digitaldanny/AudioEffectsGlove/docs/PinoutTable_v2.0.0__C2000__Breadboard_v1.0.0.xlsx

Creation Date | 2020-11-01
Last Modified Date | 2020-11-01
Breadboard Component | Breadboard Component Pin | C2000 Top-Left Left pins | C2000 Top-Left Right pins | Breadboard Component Pin | Breadboard Component | Breadboard Component | Breadboard Component Pin | C2000 Top-Right Left pins | C2000 Top-Right Right pins | Breadboard Component Pin | Breadboard Component
 |  | 1 | 21 |  |  | MCP Mux Sel 0 (CD4051BE) | 14 | 40 | 20
 |  | 2 | 22 |  |  | MCP Mux Sel 1 (CD4051BE) | 15 | 39 | 19
 |  | 3 | 23 |  |  | MCP Mux Sel 2 (CD4051BE) | 16 | 38 | 18
 |  | 4 | 24 |  |  |  |  | 37 | 17
 |  | 5 | 25 |  |  |  |  | 36 | 16
 |  | 6 | 26 |  |  |  |  | 35 | 15
 |  | 7 | 27 |  |  |  |  | 34 | 14
 |  | 8 | 28 | 3 | PIP Analog Mux Out (CD4051BE) |  |  | 33 | 13
 |  | 9 | 29 |  |  |  |  | 32 | 12
 |  | 10 | 30 | 3 | MCP Analog Mux Out (CD4051BE) |  |  | 31 | 11 | RX
Breadboard Component | Breadboard Component Pin | C2000 Bottom-Left Left pins | C2000 Bottom-Left Right pins | Breadboard Component Pin | Breadboard Component | Breadboard Component | Breadboard Component Pin | C2000 Bottom-Right Left pins | C2000 Bottom-Right Right pins | Breadboard Component Pin | Breadboard Component
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
