digitaldanny/AudioEffectsGlove/docs/PinoutTable_v1.0.0__RPi_3bp__Breadboard_v1.0.0.xlsx

Creation Date | 2020-10-31
Last Modified Date | 2020-10-31
RPi Left Side Pins | Breadboard HW Component | Breadboard HW Pin | Notes | RPi Right Side Pins | Breadboard HW Component | Breadboard HW Pin | Notes
1 |  |  |  | 2 | Power Regulator Circuit | Toggle Switch | DC 5V Power Supply
3 | Accel/Gyro/Mag | SDA |  | 4
5 | Accel/Gyro/Mag | SCL |  | 6
7 |  |  |  | 8 | HC-05 (Bluetooth) | RXD
9 | Negative Power Rail | Blue Rail | DC Ground | 10 | HC-05 (Bluetooth) | TXD
11 |  |  |  | 12
13 |  |  |  | 14
15 |  |  |  | 16
17 |  |  |  | 18
19 | External ADC (MC3008 IC) | 14 | SPI MOSI for serial communication to external ADC IC | 20
21 | External ADC (MC3008 IC) | 13 | SPI MISO for serial communication to external ADC IC | 22
23 | External ADC (MC3008 IC) | 12 | SPI CLOCK for serial communication to external ADC IC | 24
25 |  |  |  | 26 | External ADC (MC3008 IC) | 15 | SPI CHIP ENABLE for serial communication to external ADC IC
27 |  |  |  | 28
29 |  |  |  | 30
31 |  |  |  | 32
33 |  |  |  | 34
35 |  |  |  | 36 | MCP Mux (CD4051BE IC) | 14 | Mux select lines (MCP and PIP mux selects are wired together on breadboard)
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
