digitaldanny/AudioEffectsGlove/images/HW_Diagram_v3.PNG

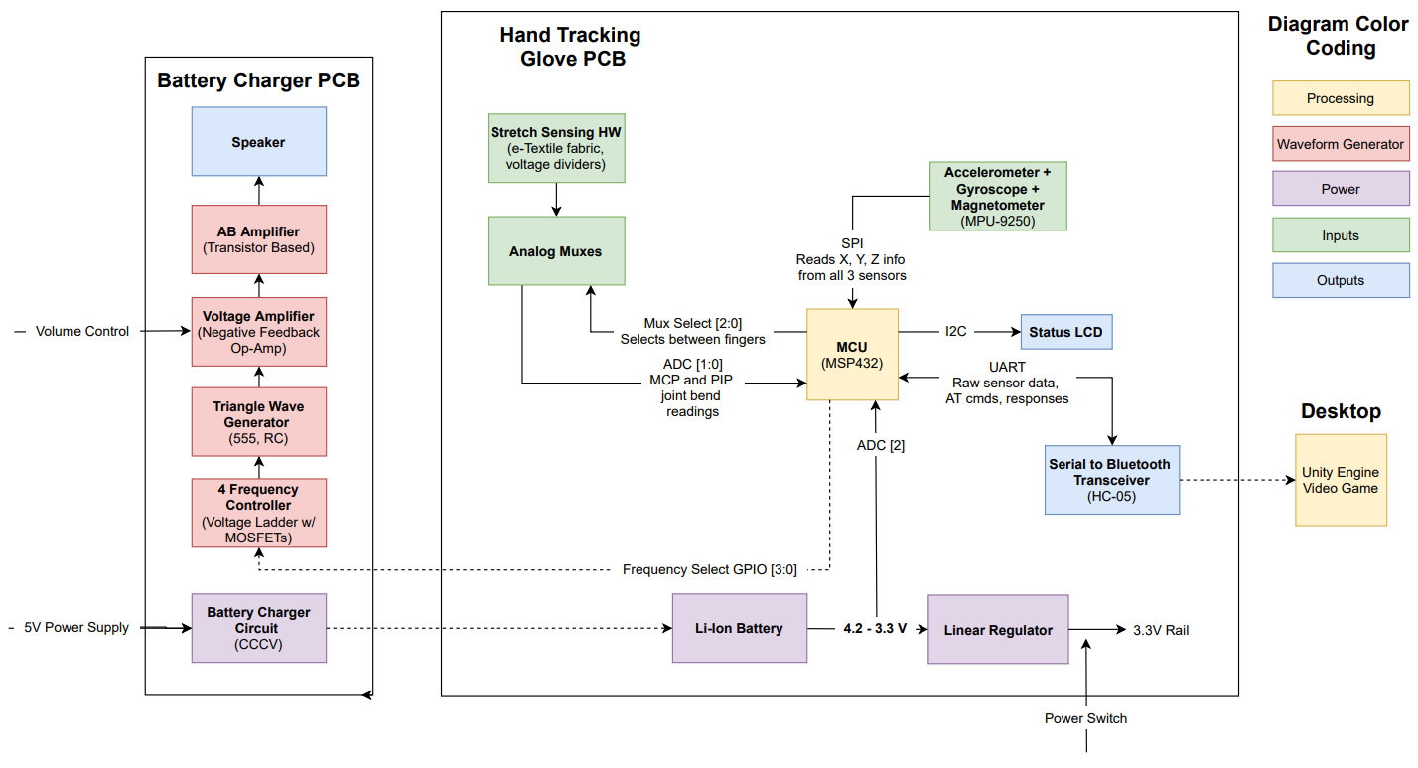
images/HW_Diagram_v3.PNG
