digitaldanny/AudioEffectsGlove/images/prototype_v1.jpg

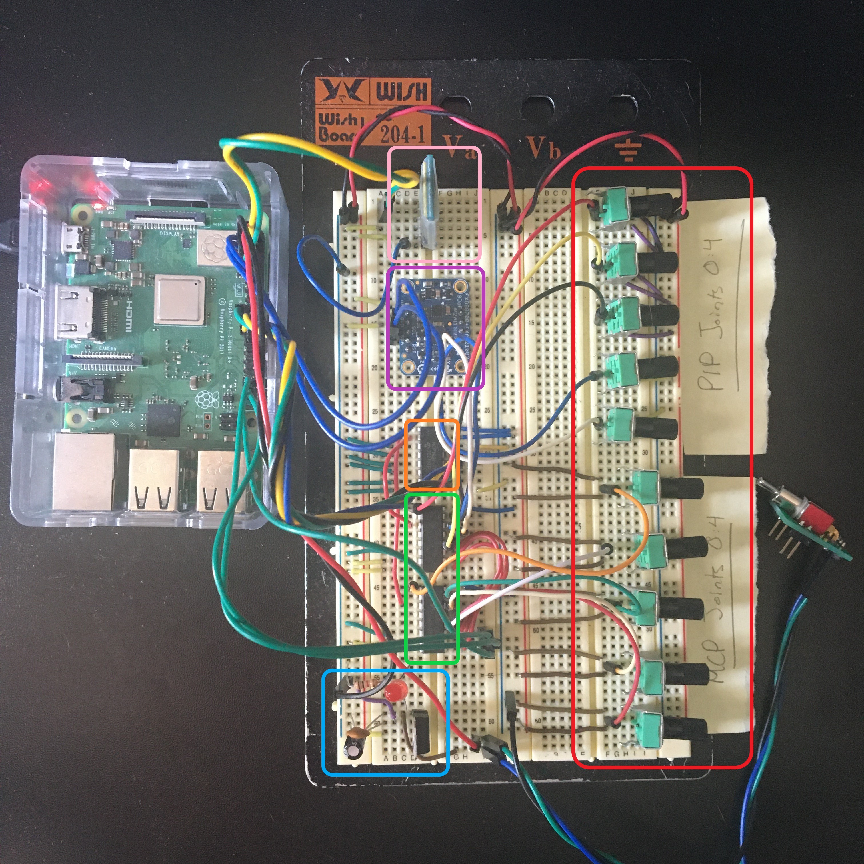
images/prototype_v1.jpg
