digitaldanny/AudioEffectsGlove/images/SW_Flowchart_v2.PNG

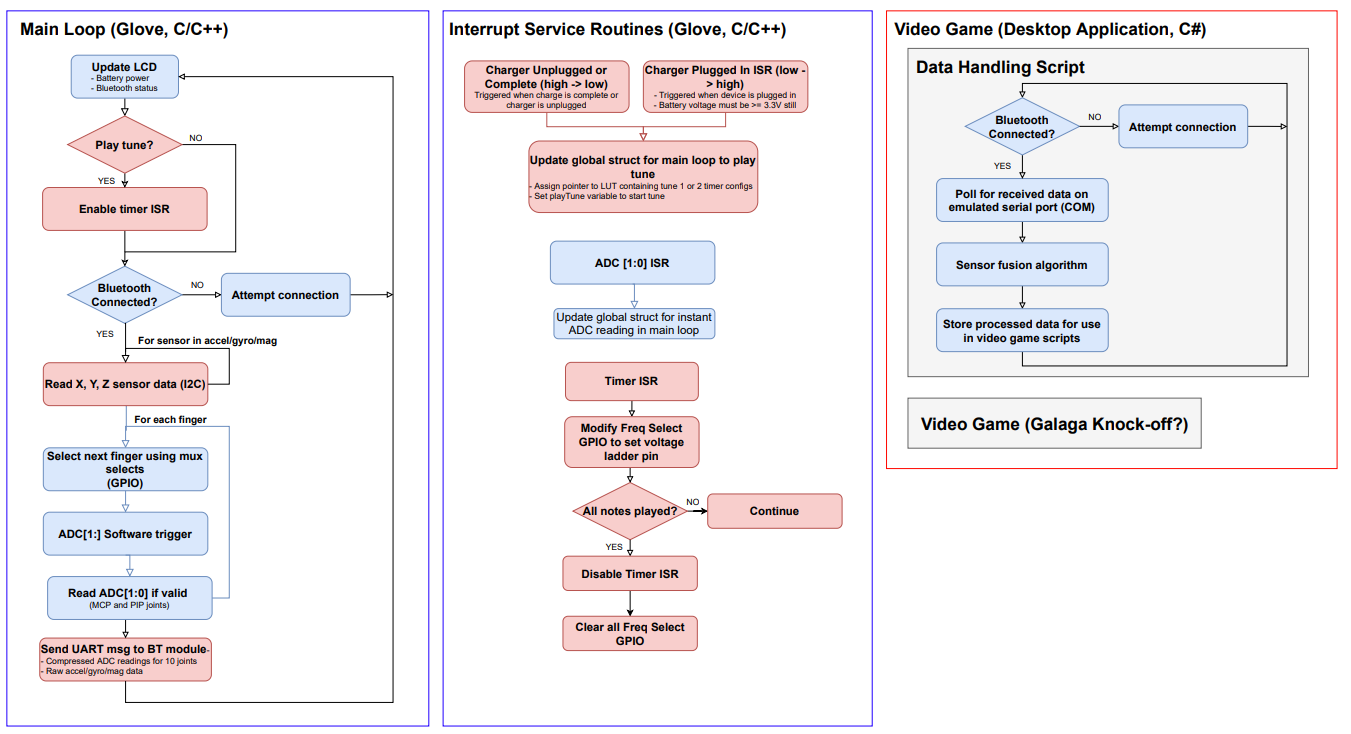
images/SW_Flowchart_v2.PNG
