digitaldanny/AudioEffectsGlove/ltspice/CCCV Battery Charger/CCCV Battery Charger.asc

Battery: voltage; EXP(3.0 4.2 2m 5m 25m 0.005)
D1: diode
D2: diode
DAD+5: voltage; 5
Q1: npn
Q2: npn
Q3: pnp
Q4: pnp
R1: res; 1k
R2: res; 2.2k
R3: res; 4.7k
R4: res; 4k
R5: res; 850
R6: res; 10k
R7: res; 1k
R8: res; .1
R9: res; 100k
R10: res; 100k
R11: res; 1k
R12: res; 1k
R13: res; 4.7k
R14: res; 100
R15: res; 10k
R16: res; 10k
Ra: res; 3.9k
Rb: res; 1k
Roff: res; 220
U1: UniversalOpamp2
U2: UniversalOpamp2
U3: UniversalOpamp2
U4: UniversalOpamp2
U5: LT1117
V1: voltage; 4.15
V2: voltage; 3.9
V3: voltage; 1m
Named nets: 0, DAD_5V, V_schmitt, V_battery, VRef_4_15, VRef_3_9, V_termination
.tran 40m
Constant Current Source (CC)
Constant Voltage Supply (CV)
3.7 - 4.2V Threshold Detector (CC/CV Switching)
2.7V
Direct compare using open loop gain (A) to swing output quicker and invert the signal (using Rail-to-Rail op-amp)
Schmitt = LOW, CC current = ON
Schmitt = HIGH, CV current = ON
3.7 - 4.2 V Triggers
high power shunt resistor (I_battery)
High when I_shunt <= 0.1C (~1.1 mA)
Termination current sensing circuit
Vcv = 4.2V
Icc = 0.1C (1.1mA in this circuit)
Termination = LOW, CV current = ON
Low-side shunt removes common mode rejection ration (CMRR) with low tolerance resistors
