digitaldanny/AudioEffectsGlove/ltspice/Wavegen and AB Amp/Wavegen and AB Amp.asc

A1: dflop
A2: xor
C1: cap; 10n
C2: cap; 10n
C3: cap; 10µ
C4: cap; 10µ
C5: cap; 4.7µ
C6: cap; 10n
C7: cap; 220µ
C8: cap; 100µ
C9: cap
C10: cap; 10n
D1: diode
D2: diode
D3: diode
D4: diode
D5: diode
D6: diode
Q1: npn
Q2: pnp
R1: res
R2: res; 1k
R3: res
R4: res
R5: res; 4.7
R6: res
R7: res; 4.7
R8: res; 1k
R9: res; 1k
R17: res
R_freq1: res; 4.7k
R_freq2: res; 6.8k
R_freq3: res; 8.2k
R_freq4: res; 12k
R_volumePot: res
Ra1: res; 7.5k
Ra3: res; 3.3k
Rb1: res; 100k
Rb2: res; 100k
U1: NE555
U2: NE555
U3: UniversalOpamp2
U4: NE555
V1: voltage
Named nets: outWaveGen555, 0, DAD_5V, outTriangleWave, outBeatClock555, outVolumeAmp, outSpeaker, outChipEnable555, GLOVE_PCB_CONNECT, upDownDir, edgeDetected
Wave generator 555 timer
Square to Triangle Converter
0.5Hz beat timer
These resistances need to be tuned using the formula f=1.44/([Ra + 2*Rb]*c)
8:1 Demux
4029 Up/Down Counter
Volume amplifier
AB Amplifier (Power amp)
2s Edge Sensing Chip Enable
Up / Down Direction Control
Rising and Falling Edge Detector
