digitaldanny/AudioEffectsGlove/ltspice/Flex Sensor to ADC/Flex Sensor to ADC.asc

Q1: pnp
R1: res; 8.2k
R2: res; 1.5k
R3: res; 10k
R_flex: res; R=V(Vresistance)
R_offset: res; 10
Rdiv: res; 18k
Rg1: res; 1.4k
Rg2: res; 1.4k
Rin1: res; 1k
Rin2: res; 1k
U1: UniversalOpamp2
U2: UniversalOpamp2
U3: UniversalOpamp2
V1: voltage; 3.3
V2: voltage; 3.3
Vs: voltage; EXP(12k 250 0 5m 1 1)
Named nets: 0, Vresistance, MuxOut, V_33, Vbias, V_boosted, V_linear, V_33N
Flex sensor voltage divider mux output
.tran 100m
Voltage reference to subtract in differential amp
Differential amp to boost voltage range of interest
Anti-log amplifier to produce linear output from log input
