digitaldanny/AudioEffectsGlove/hw_checkout/CFAL6448A_SPI/CFAL6448A_SPI.ino

//===========================================================================
//
//  Code written for Seeeduino v4.2 runnung at 3.3v
//
//  CRYSTALFONTZ CFAL6448A-066B 64x48 OLED in in 4-wire, 8-bit SPI mode
//
//  ref: https://www.crystalfontz.com/product/cfal6448a066bw
//
//  2017 - 06 - 23 Brent A. Crosby
//===========================================================================
//This is free and unencumbered software released into the public domain.
//
//Anyone is free to copy, modify, publish, use, compile, sell, or
//distribute this software, either in source code form or as a compiled
//binary, for any purpose, commercial or non-commercial, and by any
//means.
//
//In jurisdictions that recognize copyright laws, the author or authors
//of this software dedicate any and all copyright interest in the
//software to the public domain. We make this dedication for the benefit
//of the public at large and to the detriment of our heirs and
//successors. We intend this dedication to be an overt act of
//relinquishment in perpetuity of all present and future rights to this
//software under copyright law.
//
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
//For more information, please refer to <http://unlicense.org/>
//===========================================================================
#include <SPI.h>
#include "bitmaps.h"
//============================================================================
// The CFAL6448A-066B is a 3.3v device. You need a 3.3v Arduino to operate this
// code properly. We used a seeedunio v4.2 set to 3.3v:
//https://www.crystalfontz.com/product/cfapn15062-seeeduino-arduino-clone-microprocessor
//or
// http://www.seeedstudio.com/item_detail.html?p_id=2517
// 
// LCD SPI & control lines
//   ARD      | Port | LCD
// -----------+------+-------------------------
//  #8/D8     |  PB0 | LCD_RS
//  #9/D9     |  PB1 | LCD_RESET
// #10/D10    |  PB2 | LCD_CS_NOT (or SPI SS)
// #11/D11    |  PB3 | LCD_MOSI   (hardware SPI)
// #12/D12    |  PB4 | not used   (would be MISO)
// #13/D13    |  PB5 | LCD_SCK    (hardware SPI)
//
// GND => BS0 (Selects 4-wire, 8-bit SPI)
// GND => BS1 (Selects 4-wire, 8-bit SPI)
// 3.3v => VBAT
// 3.3v => VDD
//
#define CLR_RS    (PORTB &= ~(0x01))
#define SET_RS    (PORTB |=  (0x01))
#define CLR_RESET (PORTB &= ~(0x02))
#define SET_RESET (PORTB |=  (0x02))
#define CLR_CS    (PORTB &= ~(0x04))
#define SET_CS    (PORTB |=  (0x04))
#define CLR_MOSI  (PORTB &= ~(0x08))
#define SET_MOSI  (PORTB |=  (0x08))
#define CLR_SCK   (PORTB &= ~(0x20))
#define SET_SCK   (PORTB |=  (0x20))
//============================================================================
#define NUMBER_OF_SCREENS (13)
#define GEAR_START_SCREEN (5)
const SCREEN_IMAGE *const screens[NUMBER_OF_SCREENS] PROGMEM=
  {
  &Logo_6448,
  &Dimensions_6448,
  &Left_Double_6448,
  &Left_6448,
  &OLED_6448,
  &Gear_0_6448,
  &Gear_1_6448,
  &Gear_2_6448,
  &Gear_3_6448,
  &Gear_4_6448,
  &Gear_5_6448,
  &Gear_6_6448,
  &Gear_7_6448
  };
//============================================================================
void SPI_sendCommand(uint8_t command)
  {
  // Select the LCD's command register
  CLR_RS;
  // Select the LCD controller
  CLR_CS;
  //Send the command via SPI:
  SPI.transfer(command);
  // Deselect the LCD controller
  SET_CS;
  }
//============================================================================
void SPI_sendData(uint8_t data)
  {
  // Select the LCD's data register
  SET_RS;
  // Select the LCD controller
  CLR_CS;
  //Send the data via SPI:
  SPI.transfer(data);
  // Deselect the LCD controller
  SET_CS;
  }
//============================================================================
#define SSD1306B_00_SET_LOWER_COLUMN_ADDRESS_BIT (0x00)
#define SSD1306B_10_SET_UPPER_COLUMN_ADDRESS_BIT (0x10)
#define SSD1306B_B0_SET_PAGE_START_ADDRESS_BIT   (0xB0)
#define SSD1306B_DCDC_CONFIG_PREFIX_8D           (0x8D)
#define SSD1306B_DCDC_CONFIG_7p5v_14             (0x14)
#define SSD1306B_DCDC_CONFIG_6p0v_15             (0x15)
#define SSD1306B_DCDC_CONFIG_8p5v_94             (0x94)
#define SSD1306B_DCDC_CONFIG_9p0v_95             (0x95)
#define SSD1306B_DISPLAY_OFF_YES_SLEEP_AE        (0xAE)
#define SSD1306B_DISPLAY_ON_NO_SLEEP_AF          (0xAF)
#define SSD1306B_CLOCK_DIVIDE_PREFIX_D5          (0xD5)
#define SSD1306B_MULTIPLEX_RATIO_PREFIX_A8       (0xA8)
#define SSD1306B_DISPLAY_OFFSET_PREFIX_D3        (0xD3)
#define SSD1306B_DISPLAY_START_LINE_40           (0x40)
#define SSD1306B_SEG0_IS_COL_0_A0                (0xA0)
#define SSD1306B_SEG0_IS_COL_127_A1              (0xA1)
#define SSD1306B_SCAN_DIR_UP_C0                  (0xC0)
#define SSD1306B_SCAN_DIR_DOWN_C8                (0xC8)
#define SSD1306B_COM_CONFIG_PREFIX_DA            (0xDA)
#define SSD1306B_COM_CONFIG_SEQUENTIAL_LEFT_02   (0x02)
#define SSD1306B_COM_CONFIG_ALTERNATE_LEFT_12    (0x12)
#define SSD1306B_COM_CONFIG_SEQUENTIAL_RIGHT_22  (0x22)
#define SSD1306B_COM_CONFIG_ALTERNATE_RIGHT_32   (0x32)
#define SSD1306B_CONTRAST_PREFIX_81              (0x81)
#define SSD1306B_PRECHARGE_PERIOD_PREFIX_D9      (0xD9)
#define SSD1306B_VCOMH_DESELECT_PREFIX_DB        (0xDB)
#define SSD1306B_VCOMH_DESELECT_0p65xVCC_00      (0x00)
#define SSD1306B_VCOMH_DESELECT_0p71xVCC_10      (0x10)
#define SSD1306B_VCOMH_DESELECT_0p77xVCC_20      (0x20)
#define SSD1306B_VCOMH_DESELECT_0p83xVCC_30      (0x30)
#define SSD1306B_ENTIRE_DISPLAY_FORCE_ON_A5      (0xA5)
#define SSD1306B_ENTIRE_DISPLAY_NORMAL_A4        (0xA4)
#define SSD1306B_INVERSION_NORMAL_A6             (0xA6)
#define SSD1306B_INVERSION_INVERTED_A7           (0xA7)
//============================================================================
void Set_Address(uint8_t column, uint8_t page)
  {
  //Set column-lower nibble
  SPI_sendCommand(SSD1306B_00_SET_LOWER_COLUMN_ADDRESS_BIT|(column&0x0F));
  //Set column-upper nibble
  SPI_sendCommand(SSD1306B_10_SET_UPPER_COLUMN_ADDRESS_BIT|((column>>4)&0x0F));
  //Set page address, limiting from 0 to 7
  SPI_sendCommand(SSD1306B_B0_SET_PAGE_START_ADDRESS_BIT|(page&0x0F));
  }
//============================================================================
void show_64_x_48_bitmap(const SCREEN_IMAGE *OLED_image)
  {
  uint8_t
    column;
  uint8_t
    row;

  for(row=0;row<6;row++)
    {
    //Display is offest by 32 columns
    //(only 64 used of a possible 128, 32 discarded each side)
    Set_Address(32,row);

    // Select the LCD's data register
    SET_RS;
    // Select the LCD controller
    CLR_CS;
    for(column=0;column<64;column++)
      {
      //Read this byte from the program memory / flash,
      //Send the data via SPI:
      SPI.transfer(pgm_read_byte( &(OLED_image  ->bitmap_data[row][column]) ));
      }
    // Deselect the LCD controller
    SET_CS;    
    }
  }
//============================================================================
void Initialize_CFAL6448A(void)
  {
  //Thump the reset.  
  _delay_ms(1);
  CLR_RESET;
  _delay_ms(1);
  SET_RESET;
  _delay_ms(1);

  //Set the display to sleep mode for the rest of the init.
  SPI_sendCommand(SSD1306B_DISPLAY_OFF_YES_SLEEP_AE);

  //Set the clock speed, nominal ~105FPS
  //Low nibble is divide ratio
  //High level is oscillator frequency
  SPI_sendCommand(SSD1306B_CLOCK_DIVIDE_PREFIX_D5);
  SPI_sendCommand(0x80);//177Hz measured

  //Set the multiplex ratio to 1/48
  //Default is 0x3F (1/64 Duty), we need 0x2F (1/48 Duty)
  SPI_sendCommand(SSD1306B_MULTIPLEX_RATIO_PREFIX_A8);
  SPI_sendCommand(0x2F);  

  //Set the display offset to 0 (default)
  SPI_sendCommand(SSD1306B_DISPLAY_OFFSET_PREFIX_D3);
  SPI_sendCommand(0x00);

  //Set the display RAM display start line to 0 (default)
  //Bits 0-5 can be set to 0-63 with a bitwise or
  SPI_sendCommand(SSD1306B_DISPLAY_START_LINE_40);

  //Enable DC/DC converter, 9.0v
  SPI_sendCommand(SSD1306B_DCDC_CONFIG_PREFIX_8D);
  SPI_sendCommand(SSD1306B_DCDC_CONFIG_9p0v_95);

  //Map the columns correctly for our OLED glass layout
  SPI_sendCommand(SSD1306B_SEG0_IS_COL_127_A1);

  //Set COM output scan correctly for our OLED glass layout
  SPI_sendCommand(SSD1306B_SCAN_DIR_DOWN_C8);

  //Set COM pins correctly for our OLED glass layout
  SPI_sendCommand(SSD1306B_COM_CONFIG_PREFIX_DA);
  SPI_sendCommand(SSD1306B_COM_CONFIG_ALTERNATE_LEFT_12);

  //Set Contrast Control / SEG Output Current / Iref
  SPI_sendCommand(SSD1306B_CONTRAST_PREFIX_81);
  SPI_sendCommand(0xFF);  //magic # from factory

  //Set precharge (low nibble) / discharge (high nibble) timing
  //precharge = 15 clocks
  //discharge = 15 clocks
  SPI_sendCommand(SSD1306B_PRECHARGE_PERIOD_PREFIX_D9); //Set Pre-Charge period        
  SPI_sendCommand(0xFF); 

  //Set VCOM Deselect Level
  SPI_sendCommand(SSD1306B_VCOMH_DESELECT_PREFIX_DB);
  SPI_sendCommand(SSD1306B_VCOMH_DESELECT_0p65xVCC_00); 

  //Make sure Entire Display On is disabled (default)
  SPI_sendCommand(SSD1306B_ENTIRE_DISPLAY_NORMAL_A4);

  //Make sure display is not inverted (default)
  SPI_sendCommand(SSD1306B_INVERSION_NORMAL_A6);

  //Get out of sleep mode, into normal operation
  SPI_sendCommand(SSD1306B_DISPLAY_ON_NO_SLEEP_AF);
  }
//============================================================================
uint8_t
  gear_dir;
//----------------------------------------------------------------------------
void setup( void )
  {
  // LCD SPI & control lines
  //   ARD      | Port | LCD
  // -----------+------+-------------------------
  //  #8/D8     |  PB0 | LCD_RS
  //  #9/D9     |  PB1 | LCD_RESET
  // #10/D10    |  PB2 | LCD_CS_NOT (or SPI SS)
  // #11/D11    |  PB3 | LCD_MOSI   (hardware SPI)
  // #12/D12    |  PB4 | not used   (would be MISO)
  // #13/D13    |  PB5 | LCD_SCK    (hardware SPI)
  //Set the control lines to output
  DDRB |= 0x2F;

  //Drive the control lines to a reasonable starting state.
  CLR_RESET;
  CLR_RS;
  SET_CS;
  CLR_MOSI;
  CLR_SCK;

  // Initialize SPI. By default the clock is 4MHz.
  SPI.begin();
  //Bump the clock to 8MHz. Appears to be the maximum.
  SPI.beginTransaction(SPISettings(8000000, MSBFIRST, SPI_MODE0));

  //Fire up the SPI OLED
  Initialize_CFAL6448A();

  gear_dir=0;
  }
//----------------------------------------------------------------------------
void  loop(void)
  {
  uint8_t
    current_screen;
  //Put up some bitmaps from flash
  for(current_screen=0;current_screen<GEAR_START_SCREEN;current_screen++)
    {
    show_64_x_48_bitmap((SCREEN_IMAGE *)pgm_read_word(&screens[current_screen]));
    //Wait a bit . . .
    _delay_ms(1500);
    if(current_screen < 2)
      {
      //Wait a little extra for the logo & dimensions
      _delay_ms(750);
      }
    }
  //Loop the gear animation.
  uint8_t
    repeat;
  if(0==gear_dir)
    {
    for(repeat=0;repeat<25;repeat++)
      {
      for(current_screen=GEAR_START_SCREEN;current_screen<NUMBER_OF_SCREENS;current_screen++)
        {
        show_64_x_48_bitmap((SCREEN_IMAGE *)pgm_read_word(&screens[current_screen]));
        _delay_ms(20);        
        }
      }
    gear_dir=1;  
    }
  else
    {
    for(repeat=0;repeat<25;repeat++)
      {
      for(current_screen=NUMBER_OF_SCREENS-1;GEAR_START_SCREEN<=current_screen;current_screen--)
        {
        show_64_x_48_bitmap((SCREEN_IMAGE *)pgm_read_word(&screens[current_screen]));
        _delay_ms(20);        
        }
      }
    gear_dir=0;  
    }
  }
//============================================================================
