digitaldanny/AudioEffectsGlove/device/src/handTrackingGlove.cpp

#include "build_switches.h"
#if ENABLE_HAND_TRACKING_GLOVE

#include "entry_points.h"
#include "data_packet_protocol.h"
#include "hc05_api.h"
#include "flex_sensors_api.h"
#include "mpu6050_api.h"
#include "sensor_processing_lib.h"
#include "adc_if.h"
#include "state_of_charge_api.h"
#include "lcd_graphics.h"

/*
 * +=====+=====+=====+=====+=====+=====+=====+==5===+=====+=====+=====+=====+
 * DEFINES
 * +=====+=====+=====+=====+=====+=====+=====+=====+=====+=====+=====+=====+
*/

#define ADC_CH_OCV      ADC_CH3 // Open circuit voltage ADC buffer index
#define ADC_CH_CCV      ADC_CH1 // Closed circuit voltage ADC buffer index

#define LCD_ROW_BLUETOOTH_STATUS    0
#define LCD_COL_BLUETOOTH_STATUS    0
#define LCD_ROW_PITCH               1
#define LCD_ROW_ROLL                2
#define LCD_ROW_FLEX1               3
#define LCD_ROW_FLEX2               4
#define LCD_ROW_BATTERY             5

#define BLUETOOTH_TIMEOUT_COUNT     50 // Iteration count between data update to ack is expected to be around 10-15.

/*
 * +=====+=====+=====+=====+=====+=====+=====+=====+=====+=====+=====+=====+
 * STRUCTS
 * +=====+=====+=====+=====+=====+=====+=====+=====+=====+=====+=====+=====+
*/

typedef struct
{
    // Is master Hc-05 is paired with slave Hc-05?
    bool isSlaveConnected;

    // Is the slave Hc-05 ready to receive a new data packet?
    bool isSlaveReadyForUpdate;

    // If slave device has not responded within a certain number of
    // main loop iterations, the C2000 program may have restarted
    // without powering off the slave HC-05.
    uint32_t bluetoothTimeoutCounter;

    // Data packet to transfer
    dataPacket_t packet;

    // Message received back from the slave device
    // This will only contain the opcode portion of the dataPacket_t.
    char* slaveResponse;

    // 14-bit ADC reading for the battery's open circuit voltage.
    uint16_t batteryOcvAdc;
    float stateOfCharge;

    // MPU6050 sensor data
    int16_t accelBuffer[3];
    int16_t gyroBuffer[3];

    // Sensor fusion variables
    unsigned long startTime;
    float delta,wx,wy,wz;
    euler_angles angles;
    vector_ijk fusedVector;
    Quaternion qAcc;
    float pitch;
    float roll;

    // Contains message to write to a single row of the LCD
    char lcdMsg[LCD_MAX_CHARS_PER_LINE];

} gloveState_t;

/*
 * +=====+=====+=====+=====+=====+=====+=====+
 * =====+=====+=====+=====+=====+
 * GLOBALS
 * +=====+=====+=====+=====+=====+=====+=====+=====+=====+=====+=====+=====+
*/

// Contains information about the state of the main program
gloveState_t state;

/*
 * +=====+=====+=====+=====+=====+=====+=====+=====+=====+=====+=====+=====+
 * PROTOTYPES
 * +=====+=====+=====+=====+=====+=====+=====+=====+=====+=====+=====+=====+
*/

bool updateBluetoothConnectionStatus();
bool updateFlexSensorReadings();
void updatePitchRoll();
void updateLcdBatteryCharge();
void SendUpdateToSlave();
void CheckForSlaveAck();

/*
 * +=====+=====+=====+=====+=====+=====+=====+=====+=====+=====+=====+=====+
 * Description: handTrackingGlove
 * This is the main program loop of the hand tracking glove. The below bullet
 * points show the goals of this process.
 *
 * Init
 * - Capture Open Circuit Voltage of the battery to estimate an initial
 *   State of Charge.
 *
 * Loop
 * - Capture ADC readings for each flex sensor on the glove (currently 3 sensors).
 * - Capture accelerometer and gyroscope readings. Use a sensor fusion algorithm
 *   to convert these raw values into euler angles for determining hand orientation.
 * - Capture current draw and update the battery's State of Charge estimation.
 * - Check that the master HC-05 module is still connected to the slave HC-05 module.
 * - Send updated sensor data to the slave HC-05 module (DSP Effects Rack).
 * - Update the LCD with Bluetooth connection status, current draw, and battery charge.
 * +=====+=====+=====+=====+=====+=====+=====+=====+=====+=====+=====+=====+
*/
int handTrackingGlove()
{
    // Initialize glove state variable
    memset((void*)&state, 0, sizeof(gloveState_t));

    // Initialize GPIO to control external hardware power and set power to off
    initExternalHwPower();

    // Start power cycle.
    setExternalHwPower(false);

    // Configure UART to communicate with HC-05 module
    Hc05Api::SetMode(HC05MODE_DATA);

    // Enter Low-power mode and read battery's (near) open circuit voltage
    // and estimate starting battery charge.
    Adc::Init();
    state.batteryOcvAdc = Adc::ReadAdcChannel(ADC_CH_OCV);
    state.stateOfCharge = SocApi::getChargeFromOcv(state.batteryOcvAdc);

    // Finish power cycle.
    setExternalHwPower(true);

    // Configures ADC module and sets mux GPIO
    FlexSensors::Init();

    // Configures SPI module, LCD registers, and clears screen
    LcdGfx::init();

    // Configure I2C and MPU6050 module to read accelerometer and gyroscope sensor data.
    Mpu6050Api::init();

    // Initialize sensor fusion library
    state.fusedVector = vector_3d_initialize(0.0,0.0,-1.0);
    state.qAcc = quaternion_initialize(1.0,0.0,0.0,0.0);
    state.startTime = millis();

    // Slave will be ready for update as soon as master and slave connect
    state.isSlaveReadyForUpdate = true;

    // Main program loop
    while(1)
    {
        // Is slave HC-05 still paired with master HC-05?
        updateBluetoothConnectionStatus();

        // Capture and compress ADC readings for all flex sensors
        updateFlexSensorReadings();

        // Capture the latest accelerometer and gyroscope sensor readings
        Mpu6050Api::readSensorData(state.accelBuffer, state.gyroBuffer);

        // Update pitch and roll angles from accel / gyro readings.
        updatePitchRoll();

        state.stateOfCharge = SocApi::calculateStateOfCharge(state.stateOfCharge, CURRENT_LOAD_STATIC_MA);

        if (state.isSlaveConnected)
        {
            // Send the next packet to the slave device if ready
            if (state.isSlaveReadyForUpdate)
            {
                SendUpdateToSlave();
            }
            else if (state.bluetoothTimeoutCounter >= BLUETOOTH_TIMEOUT_COUNT)
            {
                // Slave device may have disconnected. Reset slaveReady bool
                // for when the device reconnects.
                state.isSlaveReadyForUpdate = true;
            }
            else
            {
                // Wait for ACK response from slave device if packet was
                // sent during current connection.
                CheckForSlaveAck();
            }
        }

        state.bluetoothTimeoutCounter++;

        // Update LCD's battery charge percentage + battery symbol
        updateLcdBatteryCharge();

        delayMs(5);
    }

    return 0;
}

/*
 * +=====+=====+=====+=====+=====+=====+=====+=====+=====+=====+=====+=====+
 * Description: updateLcdBatteryCharge
 * Update LCD's battery charge percentage + battery symbol
 * +=====+=====+=====+=====+=====+=====+=====+=====+=====+=====+=====+=====+
*/
void updateLcdBatteryCharge()
{
    // Update battery charge percentage + icon
    memset(state.lcdMsg, ' ', 10);
    if (state.stateOfCharge > 75.0f)
        sprintf(state.lcdMsg, "[####] %3.0f", state.stateOfCharge);
    else if (state.stateOfCharge > 50.0f)
        sprintf(state.lcdMsg, "[### ] %3.0f", state.stateOfCharge);
    else if (state.stateOfCharge > 25.0f)
        sprintf(state.lcdMsg, "[##  ] %3.0f", state.stateOfCharge);
    else
        sprintf(state.lcdMsg, "[#   ] %3.0f", state.stateOfCharge);

    LcdGfx::drawString(0, LCD_ROW_BATTERY, state.lcdMsg, 10);
}

/*
 * +=====+=====+=====+=====+=====+=====+=====+=====+=====+=====+=====+=====+
 * Description: updateEulerAngles
 * Use the sensor fusion algorithm to convert most recent gyroscope and
 * accelerometer readings into new Pitch and Roll values.
 * +=====+=====+=====+=====+=====+=====+=====+=====+=====+=====+=====+=====+
*/
void updatePitchRoll()
{
    // Update Euler angles from accel / gyro readings
    state.wx = 0.0005323 * state.gyroBuffer[0];
    state.wy = 0.0005323 * state.gyroBuffer[1];
    state.wz = 0.0005323 * state.gyroBuffer[2];

    state.delta = 0.001 * (millis() - state.startTime);

    state.fusedVector = update_fused_vector(state.fusedVector, state.accelBuffer[0],
                                            state.accelBuffer[1], state.accelBuffer[2],
                                            state.wx, state.wy, state.wz,
                                            state.delta);

    state.qAcc = quaternion_from_accelerometer(state.fusedVector.a,
                                               state.fusedVector.b,
                                               state.fusedVector.c);

    state.angles = quaternion_to_euler_angles(state.qAcc);
    state.startTime = millis();

    // Modify the roll values so that the resting sensor has an angle of 0.
    // Rotating right increases towards 180, rotating left decreases towards -180.
    state.roll = state.angles.roll + 180.0f;
    if (state.roll > 180.0f)
    {
        state.roll -= 360.0f;
    }

    // TODO - Modify the pitch values so that there is not any bending at the
    // top of 90 degrees and -90 degrees.
    state.pitch= state.angles.pitch;

    // Typecast to integer and store pitch/roll angles into data packet
    state.packet.pitch = (short)state.pitch;
    state.packet.roll = (short)state.roll;

    // Update LCD with Pitch and Roll angles.
    memset(state.lcdMsg, ' ', LCD_MAX_CHARS_PER_LINE);
    sprintf(state.lcdMsg, "P: %d", state.packet.pitch);
    LcdGfx::drawString(0, LCD_ROW_PITCH, state.lcdMsg, LCD_MAX_CHARS_PER_LINE);

    memset(state.lcdMsg, ' ', LCD_MAX_CHARS_PER_LINE);
    sprintf(state.lcdMsg, "R: %d", state.packet.roll);
    LcdGfx::drawString(0, LCD_ROW_ROLL, state.lcdMsg, LCD_MAX_CHARS_PER_LINE);
}

/*
 * +=====+=====+=====+=====+=====+=====+=====+=====+=====+=====+=====+=====+
 * Description: updateBluetoothConnectionStatus
 * Use the HC-05 STATE pin to check if the master HC-05 is paired with
 * the slave HC-05 on the DSP Effects Rack board.
 *
 * RETURN: Always true
 *
 * +=====+=====+=====+=====+=====+=====+=====+=====+=====+=====+=====+=====+
*/
bool updateBluetoothConnectionStatus()
{
    static uint8_t searchingCount = 0;
    static uint32_t delayCount = 0;
    static char searchingDots[4] = {" "};

    // Check if the master HC-05 module has paired with the
    // slave HC-05 module on the DSP Effects Rack C2000 board.
    state.isSlaveConnected = Hc05Api::IsSlaveConnected();

    if (state.isSlaveConnected)
    {
        memcpy(state.lcdMsg, "BT: Paired", LCD_MAX_CHARS_PER_LINE);
    }
    else
    {
        // Update the searching for slave HC-05 animation
        // (animation shifts a dot to the right in a circular loop)
        searchingDots[searchingCount] = '*';
        searchingDots[(searchingCount-1) & 0x03] = ' ';
        sprintf(state.lcdMsg, "BT: %.4s  ", searchingDots);
        if (delayCount % 10 == 0)
            searchingCount = (searchingCount+1) & 0x03;
        delayCount++;
    }

    LcdGfx::drawString(LCD_COL_BLUETOOTH_STATUS, LCD_ROW_BLUETOOTH_STATUS,
                       state.lcdMsg, LCD_MAX_CHARS_PER_LINE);

    return true;
}

/*
 * +=====+=====+=====+=====+=====+=====+=====+=====+=====+=====+=====+=====+
 * Description: updateFlexSensorReadings
 * Read all compressed flex sensors voltage values (currently 3).
 *
 * RETURN: Always true
 *
 * +=====+=====+=====+=====+=====+=====+=====+=====+=====+=====+=====+=====+
*/
bool updateFlexSensorReadings()
{
    for (uint8_t f = 0; f < FLEX_MAX_NUM_FINGERS; f++)
    {
        state.packet.flexSensors[f] = (unsigned char)FlexSensors::GetJointsData(f);
    }

    // Update LCD with flex sensor readings - flex sensor 0
    memset(state.lcdMsg, 0, LCD_MAX_CHARS_PER_LINE);
    sprintf(state.lcdMsg, "F: %03u", state.packet.flexSensors[0]);
    LcdGfx::drawString(0, LCD_ROW_FLEX1, state.lcdMsg, LCD_MAX_CHARS_PER_LINE);

    // Update LCD with flex sensor readings - flex sensors 1-2
    memset(state.lcdMsg, 0, LCD_MAX_CHARS_PER_LINE);
    sprintf(state.lcdMsg, "F: %03u %03u", state.packet.flexSensors[1], state.packet.flexSensors[2]);
    LcdGfx::drawString(0, LCD_ROW_FLEX2, state.lcdMsg, LCD_MAX_CHARS_PER_LINE);
    return true;
}

/*
 * +=====+=====+=====+=====+=====+=====+=====+=====+=====+=====+=====+=====+
 * Description: SendUpdateToSlave
 * Send latest packet of sensor data to the slave device.
 * +=====+=====+=====+=====+=====+=====+=====+=====+=====+=====+=====+=====+
*/
void SendUpdateToSlave()
{
    state.packet.opCode = DPP_OPCODE_PACKET;
    // Send next packet of data
    if (!Hc05Api::Send((char*) (&state.packet), sizeof(dataPacket_t)))
    {
        while (1); // Send transfer should not fail - trap CPU for debugging.

    }
    // Slave may still be processing the previous update.
    state.isSlaveReadyForUpdate = false;
    state.bluetoothTimeoutCounter = 0;
}

/*
 * +=====+=====+=====+=====+=====+=====+=====+=====+=====+=====+=====+=====+
 * Description: WaitForSlaveAck
 * Loop infinitely while waiting for slave device to notify master that
 * previous data packet was processed.
 * +=====+=====+=====+=====+=====+=====+=====+=====+=====+=====+=====+=====+
*/
void CheckForSlaveAck()
{
    // Wait for ACK response from slave device
    if (Hc05Api::Recv((char**) (&state.slaveResponse), 1))
    {
        // Decode response from slave device
        if (*state.slaveResponse != DPP_OPCODE_ACK)
        {
            while (1); // Slave response should only be an ACK - trap CPU for debugging.
        }

        // Slave has processed the previous update and is ready for a new one.
        state.isSlaveReadyForUpdate = true;
    }
}

#endif // ENABLE_HAND_TRACKING_GLOVE
