digitaldanny/AudioEffectsGlove/hw_checkout/CFAL6448A_SPI/bitmaps.h

#ifndef __bitmaps_h__
#define __bitmaps_h__
typedef struct
  {
  unsigned char
    bitmap_data[6][64];
  } SCREEN_IMAGE;

const SCREEN_IMAGE Logo_6448 PROGMEM =
  {
    {
      {0x00,0x00,0x00,0xC0,0xE0,0xF0,0xF8,0xFC,0x0E,0x07,0x03,0x03,0x07,0xCE,0xEC,0xF0,0xF8,0xFC,0xFE,0x07,0x03,0x03,0x07,0x0E,0xFC,0xF8,0xF0,0xE0,0xC0,0x00,0x00,0x00,0x00,0xF8,0xFE,0x17,0xF1,0xE0,0x00,0x78,0x7F,0x47,0xF8,0xF8,0x40,0x00,0x98,0xF8,0x60,0xF8,0x98,0x00,0x78,0x7F,0x47,0xF8,0xF8,0x40,0x00,0xEE,0xFF,0x11,0xFF,0xEE},
      {0xFE,0xFE,0xFE,0xFE,0xFE,0xFE,0xFE,0xFE,0xFE,0xFE,0xFE,0xFE,0x00,0xFF,0xFF,0xFF,0xFF,0xFF,0xFF,0x00,0xB6,0xB6,0xB6,0xB6,0xB6,0xB6,0xB6,0xB6,0xB6,0xB6,0xB6,0xB6,0xB6,0x00,0x01,0x01,0x01,0x00,0x1C,0x8C,0xC4,0x74,0x3D,0x0D,0x0C,0x00,0x01,0x05,0xFC,0xFD,0x05,0x00,0x00,0x00,0x04,0xFD,0xFD,0x44,0x44,0xEC,0x1D,0x01,0x01,0x00},
      {0x7F,0x7F,0x7F,0x7F,0x7F,0x7F,0x7F,0x7F,0x7F,0x7F,0x7F,0x7F,0x00,0xFF,0xFF,0xFF,0xFF,0xFF,0xFF,0x00,0x6D,0x6D,0x6D,0x6D,0x6D,0x6D,0x6D,0x6D,0x6D,0x6D,0x6D,0x6D,0x6D,0x00,0xC0,0xE0,0x30,0x10,0x16,0x37,0xE5,0xC4,0x04,0xF6,0xF7,0x00,0x00,0x04,0x07,0x07,0xF4,0xF0,0x10,0x10,0x14,0x17,0x07,0xF4,0xF0,0x10,0x10,0x70,0xE0,0x80},
      {0x00,0x00,0x00,0x03,0x07,0x0F,0x1F,0x3F,0x70,0xE0,0xC0,0xC0,0xE0,0x73,0x37,0x0F,0x1F,0x3F,0x7F,0xE0,0xC0,0xC0,0xE0,0x70,0x3F,0x1F,0x0F,0x07,0x03,0x00,0x00,0x00,0x00,0x00,0xFF,0xFF,0x00,0x00,0x00,0x00,0xFF,0xFF,0x00,0xFF,0xFF,0x00,0x00,0x00,0x00,0x00,0xFF,0xFF,0x04,0x04,0x04,0x00,0x00,0xFF,0xFF,0x00,0x00,0x80,0xFF,0x7F},
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
    }
  };


#endif // __bitmaps_h__
