digitaldanny/AudioEffectsGlove/device/src/lcd_graphics.cpp

/*
 * +=====+=====+=====+=====+=====+=====+=====+=====+=====+=====+=====+=====+=====+=====+=====+=====+
 * INCLUDES
 * +=====+=====+=====+=====+=====+=====+=====+=====+=====+=====+=====+=====+=====+=====+=====+=====+
 */

#include "lcd_graphics.h"

// 5x7 font (in 6x8 cell)
unsigned char ucSmallFont[] = {
    0x00,0x00,0x00,0x00,0x00,0x00,0x00,0x3e,0x45,0x51,0x45,0x3e,0x00,0x3e,0x6b,0x6f,
    0x6b,0x3e,0x00,0x1c,0x3e,0x7c,0x3e,0x1c,0x00,0x18,0x3c,0x7e,0x3c,0x18,0x00,0x30,
    0x36,0x7f,0x36,0x30,0x00,0x18,0x5c,0x7e,0x5c,0x18,0x00,0x00,0x18,0x18,0x00,0x00,
    0x00,0xff,0xe7,0xe7,0xff,0xff,0x00,0x3c,0x24,0x24,0x3c,0x00,0x00,0xc3,0xdb,0xdb,
    0xc3,0xff,0x00,0x30,0x48,0x4a,0x36,0x0e,0x00,0x06,0x29,0x79,0x29,0x06,0x00,0x60,
    0x70,0x3f,0x02,0x04,0x00,0x60,0x7e,0x0a,0x35,0x3f,0x00,0x2a,0x1c,0x36,0x1c,0x2a,
    0x00,0x00,0x7f,0x3e,0x1c,0x08,0x00,0x08,0x1c,0x3e,0x7f,0x00,0x00,0x14,0x36,0x7f,
    0x36,0x14,0x00,0x00,0x5f,0x00,0x5f,0x00,0x00,0x06,0x09,0x7f,0x01,0x7f,0x00,0x22,
    0x4d,0x55,0x59,0x22,0x00,0x60,0x60,0x60,0x60,0x00,0x00,0x14,0xb6,0xff,0xb6,0x14,
    0x00,0x04,0x06,0x7f,0x06,0x04,0x00,0x10,0x30,0x7f,0x30,0x10,0x00,0x08,0x08,0x3e,
    0x1c,0x08,0x00,0x08,0x1c,0x3e,0x08,0x08,0x00,0x78,0x40,0x40,0x40,0x40,0x00,0x08,
    0x3e,0x08,0x3e,0x08,0x00,0x30,0x3c,0x3f,0x3c,0x30,0x00,0x03,0x0f,0x3f,0x0f,0x03,
    0x00,0x00,0x00,0x00,0x00,0x00,0x00,0x00,0x06,0x5f,0x06,0x00,0x00,0x07,0x03,0x00,
    0x07,0x03,0x00,0x24,0x7e,0x24,0x7e,0x24,0x00,0x24,0x2b,0x6a,0x12,0x00,0x00,0x63,
    0x13,0x08,0x64,0x63,0x00,0x36,0x49,0x56,0x20,0x50,0x00,0x00,0x07,0x03,0x00,0x00,
    0x00,0x00,0x3e,0x41,0x00,0x00,0x00,0x00,0x41,0x3e,0x00,0x00,0x00,0x08,0x3e,0x1c,
    0x3e,0x08,0x00,0x08,0x08,0x3e,0x08,0x08,0x00,0x00,0xe0,0x60,0x00,0x00,0x00,0x08,
    0x08,0x08,0x08,0x08,0x00,0x00,0x60,0x60,0x00,0x00,0x00,0x20,0x10,0x08,0x04,0x02,
    0x00,0x3e,0x51,0x49,0x45,0x3e,0x00,0x00,0x42,0x7f,0x40,0x00,0x00,0x62,0x51,0x49,
    0x49,0x46,0x00,0x22,0x49,0x49,0x49,0x36,0x00,0x18,0x14,0x12,0x7f,0x10,0x00,0x2f,
    0x49,0x49,0x49,0x31,0x00,0x3c,0x4a,0x49,0x49,0x30,0x00,0x01,0x71,0x09,0x05,0x03,
    0x00,0x36,0x49,0x49,0x49,0x36,0x00,0x06,0x49,0x49,0x29,0x1e,0x00,0x00,0x6c,0x6c,
    0x00,0x00,0x00,0x00,0xec,0x6c,0x00,0x00,0x00,0x08,0x14,0x22,0x41,0x00,0x00,0x24,
    0x24,0x24,0x24,0x24,0x00,0x00,0x41,0x22,0x14,0x08,0x00,0x02,0x01,0x59,0x09,0x06,
    0x00,0x3e,0x41,0x5d,0x55,0x1e,0x00,0x7e,0x11,0x11,0x11,0x7e,0x00,0x7f,0x49,0x49,
    0x49,0x36,0x00,0x3e,0x41,0x41,0x41,0x22,0x00,0x7f,0x41,0x41,0x41,0x3e,0x00,0x7f,
    0x49,0x49,0x49,0x41,0x00,0x7f,0x09,0x09,0x09,0x01,0x00,0x3e,0x41,0x49,0x49,0x7a,
    0x00,0x7f,0x08,0x08,0x08,0x7f,0x00,0x00,0x41,0x7f,0x41,0x00,0x00,0x30,0x40,0x40,
    0x40,0x3f,0x00,0x7f,0x08,0x14,0x22,0x41,0x00,0x7f,0x40,0x40,0x40,0x40,0x00,0x7f,
    0x02,0x04,0x02,0x7f,0x00,0x7f,0x02,0x04,0x08,0x7f,0x00,0x3e,0x41,0x41,0x41,0x3e,
    0x00,0x7f,0x09,0x09,0x09,0x06,0x00,0x3e,0x41,0x51,0x21,0x5e,0x00,0x7f,0x09,0x09,
    0x19,0x66,0x00,0x26,0x49,0x49,0x49,0x32,0x00,0x01,0x01,0x7f,0x01,0x01,0x00,0x3f,
    0x40,0x40,0x40,0x3f,0x00,0x1f,0x20,0x40,0x20,0x1f,0x00,0x3f,0x40,0x3c,0x40,0x3f,
    0x00,0x63,0x14,0x08,0x14,0x63,0x00,0x07,0x08,0x70,0x08,0x07,0x00,0x71,0x49,0x45,
    0x43,0x00,0x00,0x00,0x7f,0x41,0x41,0x00,0x00,0x02,0x04,0x08,0x10,0x20,0x00,0x00,
    0x41,0x41,0x7f,0x00,0x00,0x04,0x02,0x01,0x02,0x04,0x00,0x80,0x80,0x80,0x80,0x80,
    0x00,0x00,0x03,0x07,0x00,0x00,0x00,0x20,0x54,0x54,0x54,0x78,0x00,0x7f,0x44,0x44,
    0x44,0x38,0x00,0x38,0x44,0x44,0x44,0x28,0x00,0x38,0x44,0x44,0x44,0x7f,0x00,0x38,
    0x54,0x54,0x54,0x08,0x00,0x08,0x7e,0x09,0x09,0x00,0x00,0x18,0xa4,0xa4,0xa4,0x7c,
    0x00,0x7f,0x04,0x04,0x78,0x00,0x00,0x00,0x00,0x7d,0x40,0x00,0x00,0x40,0x80,0x84,
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
};

/*
 * +=====+=====+=====+=====+=====+=====+=====+=====+=====+=====+=====+=====+=====+=====+=====+=====+
 * FUNCTION IMPLEMENTATIONS
 * +=====+=====+=====+=====+=====+=====+=====+=====+=====+=====+=====+=====+=====+=====+=====+=====+
 */

bool LcdGfx::init()
{
    lcd_setup(); // lcd register configuration
    LcdGfx::drawFill(0x00); // clear screen
    return true;
}

/*
 * +-----+-----+-----+-----+-----+-----+-----+-----+-----+-----+-----+-----+-----+
 * DESCRIPTION: LcdGfx::writeDataBlock
 * Initialize GPIO to control the mux selects.
 *
 * NOTE - This function belongs in the cfa6448A_lcd.cpp file, but I am placing it
 * here to minimize changing the 3rd party libraries as much as possible.
 *
 * INPUTS:
 * @data - Pointer to buffer to transfer.
 * @len - Length of the data buffer.
 *
 * RETURN: True if transfer was successful.
 * +-----+-----+-----+-----+-----+-----+-----+-----+-----+-----+-----+-----+-----+
*/
bool LcdGfx::writeDataBlock(unsigned char* data, uint16_t len)
{
    // Select the LCD's data register
    SET_RS;

    // Select the LCD controller
    CLR_CS;

    for(uint16_t i = 0; i < len; i++)
    {
      //Read this byte from the program memory / flash,
      //Send the data via SPI:
      SPI.transfer(data[i]);
    }

    // Deselect the LCD controller
    SET_CS;
    return true;
}

/*
 * +-----+-----+-----+-----+-----+-----+-----+-----+-----+-----+-----+-----+-----+
 * DESCRIPTION: LcdGfx::drawString
 * Draws input message to a specified position on the screen.
 *
 * INPUTS:
 * @x - Starting column in character widths (6 for small font).
 * @y - Starting row in memory pages (8 lines each).
 * @msg - Pointer to message to write.
 * @msgLen - Number of characters in the message.
 *
 * RETURN: True if transfer was successful.
 * +-----+-----+-----+-----+-----+-----+-----+-----+-----+-----+-----+-----+-----+
*/
#define CHAR_WIDTH  6
bool LcdGfx::drawString(uint8_t x, uint8_t y, char* msg, uint16_t msgLen)
{
    unsigned char *s;

    Set_Address(CHAR_WIDTH*(x + 6), y);
    for (uint16_t i = 0; i < msgLen; i++)
    {
        s = &ucSmallFont[(unsigned char)msg[i]*CHAR_WIDTH];
        writeDataBlock(s, CHAR_WIDTH);
    }
    return true;
}

/*
 * +-----+-----+-----+-----+-----+-----+-----+-----+-----+-----+-----+-----+-----+
 * DESCRIPTION: LcdGfx::drawFill
 * Fills entire LCD with a byte pattern (0x00 for all off, 0xFF for all on).
 *
 * INPUTS:
 * @pattern - Pattery to fill LCD with.
 *
 * RETURN: True if transfer was successful.
 * +-----+-----+-----+-----+-----+-----+-----+-----+-----+-----+-----+-----+-----+
*/
#define NUM_LINES   8
#define NUM_COLS    8
unsigned char patternBuf[16*NUM_COLS];
bool LcdGfx::drawFill(unsigned char pattern)
{
    memset(patternBuf, pattern, 16*NUM_COLS);

    for (uint8_t y = 0; y < NUM_LINES; y++)
    {
        Set_Address(0, y); // set to (0,Y)
        writeDataBlock(patternBuf, 16*NUM_COLS); // fill with data byte
    } // for y
    return 0;
}
