digitaldanny/AudioEffectsGlove/device/inc/target_hw_common.h

/*
 * +=====+=====+=====+=====+=====+=====+=====+=====+=====+=====+=====+=====+
 * DESCRIPTION: setup_target_hw.h
 * This file contains headers/functions to initialize **non-module** target hardware
 * and common helper functions for hardware setup.
 *
 * Examples of inits in this file) Setting clock speed, disabling WDT
 * Examples of inits NOT in this file) Configuring UART for transmitting Bluetooth data
 * +=====+=====+=====+=====+=====+=====+=====+=====+=====+=====+=====+=====+
*/

/*
 * +=====+=====+=====+=====+=====+=====+=====+=====+=====+=====+=====+=====+
 * INCLUDES
 * +=====+=====+=====+=====+=====+=====+=====+=====+=====+=====+=====+=====+
*/
#ifndef _SETUP_TARGET_HARDWARE
#define _SETUP_TARGET_HARDWARE

#include <string.h>
#include "build_switches.h"

#if TARGET_HW_C2000
extern "C" {
 #include "device.h"
}
#endif // TARGET_HW_C2000

#if TARGET_HW_MSP432
extern "C" {
 #include "driverlib.h"
}
#endif // TARGET_HW_MSP432

/*
 * +=====+=====+=====+=====+=====+=====+=====+=====+=====+=====+=====+=====+
 * DEFINES
 * +=====+=====+=====+=====+=====+=====+=====+=====+=====+=====+=====+=====+
*/

/// SYSTEM INFO DEFINES ///
#define SYSINFO_EXTERNALHWPOWER_ENABLE  systemInfo.externalHwPowerEnable

/// SYSTEM IO DEFINES ///
#define SYSIO_PIN_EXTERNALHWPOWER_PORT  systemIO.externalHwPower.port
#define SYSIO_PIN_EXTERNALHWPOWER_PIN   systemIO.externalHwPower.pin

#define SYSIO_PIN_BLUETOOTHENABLE_PORT  systemIO.bluetoothEn.port
#define SYSIO_PIN_BLUETOOTHENABLE_PIN   systemIO.bluetoothEn.pin

/*
 * +=====+=====+=====+=====+=====+=====+=====+=====+=====+=====+=====+=====+
 * STRUCTS
 * +=====+=====+=====+=====+=====+=====+=====+=====+=====+=====+=====+=====+
*/

/*
 * +-----+-----+-----+-----+-----+-----+-----+-----+-----+
 * SUMMARY: pinPort_t
 * This struct contains port/pin parameters for an MSP432 pin.
 * +-----+-----+-----+-----+-----+-----+-----+-----+-----+
 */
typedef struct
{
#ifdef TARGET_HW_MSP432
    uint_fast8_t port;
    uint_fast16_t pin;
#endif // TARGET_HW_MSP432
} pinPort_t;

/*
 * +-----+-----+-----+-----+-----+-----+-----+-----+-----+
 * SUMMARY: systemInfo_t
 * This struct contains information about the system hardware's
 * state.
 *
 * FIELD DESCRIPTIONS:
 * @externalHwPowerEnable - Issue #45
 *  Is power enabled for other hardware (HC-05, MPU6500, Flex Sensors, etc)?
 *@millisCount - Issue #64
 *  Number of milliseconds counted since the program started running.
 * +-----+-----+-----+-----+-----+-----+-----+-----+-----+
 */
typedef struct
{
    bool externalHwPowerEnable;
    uint32_t millisCount;
} systemInfo_t;


/*
 * +-----+-----+-----+-----+-----+-----+-----+-----+-----+
 * SUMMARY: systemIO_t
 * This struct contains information about the system hardware's
 * state.
 *
 * FIELD DESCRIPTIONS:
 * @externalHwPower - Issue #45
 *  Enables power for external hardware (LCD, MPU6500, HC-05, etc)
 * @bluetoothEn - Issue #37
 *  Controls whether HC-05 module operates in data or command mode.
 * @bluetoothState - Issue #37
 *  Checks if HC-05 master is connected to slave device.
 * @uartTx/Rx
 *  Uart pins to communicate with HC-05 device.
 * @i2cSda/Scl
 *  I2C lines to communicate with MPU6050.
 * @spiMiso/Mosi/Clk/Cs1
 *  SPI lines to communicate with LCD. Cs1 is a generic GPIO.
 * @lcdRs
 *  Register select determines if LCD is in data or command mode.
 * @lcdReset
 *  Active low reset for LCD.
 * @flexAdc
 *  ADC14 pin for reading amplified and filtered flex sensor outputs.
 * @flexMux{0-2}
 *  GPIO outputs for controlling flex sensor mux selects.
 * @ocvAdc
 *  ADC pin to measure battery's Open Circuit Voltage.
 * @loadCurrentAdc
 *  ADC pin to measure battery's Closed Circuit Voltage (runtime current draw).
 * @spareGpio
 *  Spare GPIO for various testing. Not available on the PCB.
 * +-----+-----+-----+-----+-----+-----+-----+-----+-----+
 */
typedef struct
{
    pinPort_t externalHwPower;
    pinPort_t bluetoothEn;
    pinPort_t bluetoothState;
    pinPort_t uartTx;
    pinPort_t uartRx;
    pinPort_t i2cSda;
    pinPort_t i2cScl;
    pinPort_t spiMiso;
    pinPort_t spiMosi;
    pinPort_t spiClk;
    pinPort_t spiCs1;
    pinPort_t lcdRs;
    pinPort_t lcdReset;
    pinPort_t flexAdc;
    pinPort_t flexMux[3];
    pinPort_t ocvAdc;
    pinPort_t ccvAdc;
    pinPort_t spareAdc;
    pinPort_t spareGpio;
} systemIO_t;

/*
 * +=====+=====+=====+=====+=====+=====+=====+=====+=====+=====+=====+=====+
 * GLOBALS
 * +=====+=====+=====+=====+=====+=====+=====+=====+=====+=====+=====+=====+
*/

extern volatile systemInfo_t systemInfo;
extern const systemIO_t systemIO;

/*
 * +=====+=====+=====+=====+=====+=====+=====+=====+=====+=====+=====+=====+
 * PROTOTYPES
 * +=====+=====+=====+=====+=====+=====+=====+=====+=====+=====+=====+=====+
*/

void initExternalHwPower();
void setupTargetHw();
void delayMs(uint32_t ms) ;
void delayUs(uint32_t us);
void setExternalHwPower(bool enable);
uint32_t millis();

#endif // _SETUP_TARGET_HARDWARE
