digitaldanny/AudioEffectsGlove/device/src/spi_if.cpp

/*
 * +=====+=====+=====+=====+=====+=====+=====+=====+=====+=====+=====+=====+
 * DESCRIPTION: spi_if.cpp
 * This file contains functions to configure/use SPI.
 * +=====+=====+=====+=====+=====+=====+=====+=====+=====+=====+=====+=====+
*/

#include "spi_if.h"

/*
 * +=====+=====+=====+=====+=====+=====+=====+=====+=====+=====+=====+=====+
 * GLOBALS
 * +=====+=====+=====+=====+=====+=====+=====+=====+=====+=====+=====+=====+
*/

#ifdef TARGET_HW_MSP432
/*
 * +-----+-----+-----+-----+-----+-----+-----+-----+-----+-----+-----+-----+-----+
 * DESCRIPTION: spiMasterConfig
 * Configurations for EUSCI_B0 pins (P1.5-P1.7) for 3-wire master SPI.
 *
 * DETAILS:
 * - SMCLK Clock Source
 * - SMCLK = DCO = 48MHZ
 * - SPICLK = 500khz
 * - MSB First
 * - Phase
 * - High polarity (high when inactive)
 * - 3-Wire SPI Mode
 * +-----+-----+-----+-----+-----+-----+-----+-----+-----+-----+-----+-----+-----+
*/
static eUSCI_SPI_MasterConfig spiMasterConfig =
{
        EUSCI_B_SPI_CLOCKSOURCE_SMCLK,
        0, // set during runtime
        8000000,
        EUSCI_B_SPI_MSB_FIRST,
        EUSCI_B_SPI_PHASE_DATA_CAPTURED_ONFIRST_CHANGED_ON_NEXT,
        EUSCI_B_SPI_CLOCKPOLARITY_INACTIVITY_LOW,
        EUSCI_B_SPI_3PIN
};

static volatile Spi::spiRxData_t spiRxData; // Contains response data from SPI slave

#endif // TARGET_HW_MSP432

/*
* +=====+=====+=====+=====+=====+=====+=====+=====+=====+=====+=====+=====+
* TOP LEVEL FUNCTIONS
* +=====+=====+=====+=====+=====+=====+=====+=====+=====+=====+=====+=====+
*/

void Spi::init()
{
#ifdef TARGET_HW_MSP432
    Spi::MSP432::init();
#endif // TARGET_HW_MSP432
}

uint8_t Spi::transferByte(uint8_t data)
{
#ifdef TARGET_HW_MSP432
    return Spi::MSP432::transferByte(data);
#else
    return 0;
#endif // TARGET_HW_MSP432
}

#ifdef TARGET_HW_MSP432
/*
* +=====+=====+=====+=====+=====+=====+=====+=====+=====+=====+=====+=====+
* MSP432 IMPLEMENTATIONS
* +=====+=====+=====+=====+=====+=====+=====+=====+=====+=====+=====+=====+
*/

/*
 * +-----+-----+-----+-----+-----+-----+-----+-----+-----+-----+-----+-----+-----+
 * DESCRIPTION: Spi::MSP432::init
 * Configure EUSCI_B0 pins (P1.5-P1.7) for 3-wire master Spi.
 * Configuration details included in the description for the 'spiMasterConfig' struct.
 *
 * INPUTS: N/A
 * RETURN: N/A
 * +-----+-----+-----+-----+-----+-----+-----+-----+-----+-----+-----+-----+-----+
*/
void Spi::MSP432::init()
{
    /* Selecting P1.5 P1.6 and P1.7 in SPI mode */
    MAP_GPIO_setAsPeripheralModuleFunctionInputPin(systemIO.spiClk.port,
        systemIO.spiClk.pin | systemIO.spiMosi.pin | systemIO.spiMiso.pin,
        GPIO_PRIMARY_MODULE_FUNCTION);

    /* Configuring SPI in 3wire master mode */
    spiMasterConfig.clockSourceFrequency = CS_getSMCLK();
    MAP_SPI_initMaster(EUSCI_B0_BASE, &spiMasterConfig);

    /* Enable SPI module */
    MAP_SPI_enableModule(EUSCI_B0_BASE);

    /* Enabling interrupt on receive */
    MAP_SPI_enableInterrupt(EUSCI_B0_BASE, EUSCI_B_SPI_RECEIVE_INTERRUPT);
    MAP_Interrupt_enableInterrupt(INT_EUSCIB0);
}

/*
 * +-----+-----+-----+-----+-----+-----+-----+-----+-----+-----+-----+-----+-----+
 * DESCRIPTION: Spi::MSP432::transferByte
 * Transfer a byte of data to the SPI slave and read back the response.
 *
 * INPUTS:
 * @data - byte of data to transfer.
 *
 * RETURN:
 * @uint8_t - byte of data received from slave.
 * +-----+-----+-----+-----+-----+-----+-----+-----+-----+-----+-----+-----+-----+
*/
uint8_t Spi::MSP432::transferByte(uint8_t data)
{
    spiRxData.flagSpiReady = false;

    /* Polling to see if the TX buffer is ready */
    while (!MAP_SPI_getInterruptStatus(EUSCI_B0_BASE,EUSCI_B_SPI_TRANSMIT_INTERRUPT));

    /* Transmitting data to slave */
    MAP_SPI_transmitData(EUSCI_B0_BASE, data);

    /* Wait for IRQ handler to receive and store returned data */
    while (!spiRxData.flagSpiReady);

    return spiRxData.data;
}

/*
 * +-----+-----+-----+-----+-----+-----+-----+-----+-----+-----+-----+-----+-----+
 * DESCRIPTION: EUSCIB0_IRQHandler
 * SPI receive handler as defined in startup_msp432p401r_ccs.c -> interruptVectors.
 *
 * This handler completes the following tasks:
 * - Clears SPI RX interrupt flag.
 * - Reads data received from SPI slave.
 * - Sets global flag to "true" to notify main program that response was received.
 * +-----+-----+-----+-----+-----+-----+-----+-----+-----+-----+-----+-----+-----+
*/
extern "C" void EUSCIB0_IRQHandler(void)
{
    uint32_t status = MAP_SPI_getEnabledInterruptStatus(EUSCI_B0_BASE);

    MAP_SPI_clearInterruptFlag(EUSCI_B0_BASE, status);

    if(status & EUSCI_B_SPI_RECEIVE_INTERRUPT)
    {
        /* USCI_B0 TX buffer ready? */
        while (!(MAP_SPI_getInterruptStatus(EUSCI_B0_BASE, EUSCI_B_SPI_TRANSMIT_INTERRUPT)));

        // Store the slave response into global variable
        spiRxData.data = MAP_SPI_receiveData(EUSCI_B0_BASE);

        // Notify main program that SPI response has been received
        spiRxData.flagSpiReady = true;
    }

}
#endif // TARGET_HW_MSP432
