digitaldanny/AudioEffectsGlove/device/inc/entry_points.h

#ifndef _SRC_ENTRY_POINTS
#define _SRC_ENTRY_POINTS

#include "build_switches.h"

/*
 * +=====+=====+=====+=====+=====+=====+=====+=====+=====+=====+=====+=====+
 * UNIT TESTS
 * +=====+=====+=====+=====+=====+=====+=====+=====+=====+=====+=====+=====+
*/

#if ENABLE_UNIT_TEST_EXT_PWR_SWITCH
void unitTest_enableExternalHwPower();
#endif // ENABLE_UNIT_TEST_EXT_PWR_SWITCH

#if ENABLE_UNIT_TEST_WIRELESS_API
int unitTest_wirelessApi();
#endif // ENABLE_UNIT_TEST_WIRELESS_API

#if ENABLE_UNIT_TEST_NXP_API
int unitTest_nxpApi();
#endif // ENABLE_UNIT_TEST_NXP_API

#if ENABLE_UNIT_TEST_MUX
int unitTest_mux();
#endif // ENABLE_UNIT_TEST_MUX

#if ENABLE_UNIT_TEST_MUX_LP
int unitTest_muxLp();
#endif // ENABLE_UNIT_TEST_MUX_C2000

#if ENABLE_UNIT_TEST_ADC
int unitTest_adc();
#endif // ENABLE_UNIT_TEST_ADC

#if ENABLE_UNIT_TEST_ADC_C2000
int unitTest_adcC2000();
#endif // ENABLE_UNIT_TEST_ADC_C2000

#if ENABLE_UNIT_TEST_ADC_MSP432
int unitTest_adcMsp432();
#endif // ENABLE_UNIT_TEST_ADC_MSP432

#if ENABLE_UNIT_TEST_FLEX_SENSORS
int unitTest_flexSensors();
#endif // ENABLE_UNIT_TEST_FLEX_SENSORS

#if ENABLE_UNIT_TEST_HC05_DEVICE_NAME
int unitTest_hc05DeviceName();
#endif // ENABLE_UNIT_TEST_HC05_DEVICE_NAME

#if ENABLE_UNIT_TEST_HC05_RW_TO_SLAVE
int unitTest_hc05RwToSlave();
#endif // ENABLE_UNIT_TEST_HC05_RW_TO_SLAVE

#if ENABLE_UNIT_TEST_MPU6500_WHOAMI_SPI
int TEST_mpu6500WhoAmISpi();
#endif // ENABLE_UNIT_TEST_MPU6500_WHOAMI_SPI

#if ENABLE_UNIT_TEST_MPU6050_WHOAMI_I2C
int TEST_mpu6500WhoAmII2c();
#endif // ENABLE_UNIT_TEST_MPU6050_WHOAMI_I2C

#if ENABLE_UNIT_TEST_MPU6050_SENSORDATA_RAW
int TEST_mpu6500RawSensorData();
#endif // ENABLE_UNIT_TEST_MPU6050_SENSORDATA_RAW

#if ENABLE_UNIT_TEST_TIMER_DELAY
int TEST_timerDelay();
#endif // ENABLE_UNIT_TEST_TIMER_DELAY

#if ENABLE_UNIT_TEST_LCD_DEMO
int TEST_lcdProductDemo();
#endif // ENABLE_UNIT_TEST_LCD_DEMO

#if ENABLE_UNIT_TEST_LCD_TEXT
int TEST_lcdGraphics();
#endif // ENABLE_UNIT_TEST_LCD_TEXT

#if ENABLE_UNIT_TEST_STATE_OF_CHARGE
int unitTest_stateOfCharge();
#endif // ENABLE_UNIT_TEST_STATE_OF_CHARGE

/*
 * +=====+=====+=====+=====+=====+=====+=====+=====+=====+=====+=====+=====+
 * MAIN PROGRAMS
 * +=====+=====+=====+=====+=====+=====+=====+=====+=====+=====+=====+=====+
*/

#if ENABLE_MPU6050_ESTIMATE_GYRO_ERROR
int mpu6050GyroError();
#endif // ENABLE_MPU6050_ESTIMATE_GYRO_ERROR

#if ENABLE_HC05_CONFIG_MSTR
int unitTest_hc05ConfigMaster();
#endif // ENABLE_HC05_CONFIG_MSTR

#if ENABLE_HAND_TRACKING_GLOVE
int handTrackingGlove();
#endif // ENABLE_HAND_TRACKING_GLOVE

#endif // _SRC_ENTRY_POINTS
