digitaldanny/AudioEffectsGlove/demo/inc/hc05.h

#ifndef _SRC_HC05_C2000
#define _SRC_HC05_C2000

/*
 * +=====+=====+=====+=====+=====+=====+=====+=====+=====+=====+=====+=====+
 * INCLUDES
 * +=====+=====+=====+=====+=====+=====+=====+=====+=====+=====+=====+=====+
*/
#include "driverlib.h"
#include "device.h"
#include "data_packet_protocol.h"
#include <string.h>

/*
 * +=====+=====+=====+=====+=====+=====+=====+=====+=====+=====+=====+=====+
 * DEFINES
 * +=====+=====+=====+=====+=====+=====+=====+=====+=====+=====+=====+=====+
*/

#define ENABLE_SCIC_LOOPBACK_TEST       0
#define ENABLE_HC05_NAME_TEST           0
#define ENABLE_HC05_RW_TO_MASTER_TEST   0
#define ENABLE_HC05_DATA_PACKET_TEST    0

// Running project on laptop uses a different driverlib version
// that divides the clocks differently.
#define DRIVERLIB_2

#ifdef DRIVERLIB_2
 #define BAUDRATE_38400      (38400>>1)
 #define BAUDRATE_9600       (9600>>1)
#else
 #define BAUDRATE_38400      (38400<<1)
 #define BAUDRATE_9600       (9600<<1)
#endif // DRIVERLIB_2
#define BAUDRATE_DEFAULT    BAUDRATE_9600

#define SCI_MAX_BUFFER_LENGTH       100

/*
 * +=====+=====+=====+=====+=====+=====+=====+=====+=====+=====+=====+=====+
 * PROTOTYPES
 * +=====+=====+=====+=====+=====+=====+=====+=====+=====+=====+=====+=====+
*/

// Unit tests
#if ENABLE_SCIC_LOOPBACK_TEST
bool loopbackTest();
#endif // ENABLE_SCIC_LOOPBACK_TEST

#if ENABLE_HC05_NAME_TEST
bool hc05NameTest();
#endif // ENABLE_HC05_NAME_TEST

#if ENABLE_HC05_RW_TO_MASTER_TEST
bool hc05RwToMasterTest();
#endif // ENABLE_HC05_RW_TO_MASTER_TEST

#if ENABLE_HC05_DATA_PACKET_TEST
bool messageProtocolTest();
#endif // ENABLE_HC05_DATA_PACKET_TEST

// HC-05 API
void initHc05();
bool resetBuffersHc05();
bool writeHc05(uint16_t* msg, uint16_t len);
bool readHc05(uint16_t** rx, uint16_t len);
bool readHc05NonBlocking(uint16_t** rx, uint16_t len);

// SCI drivers
__interrupt void sciCTXFIFOISR(void);
__interrupt void sciCRXFIFOISR(void);
void initSCIC(void);
void initSCICFIFO(void);

#endif // _SRC_HC05_C2000
