digitaldanny/AudioEffectsGlove/(commit log)

2020-08-16 Accel/Gyro/Mag wrapper class + C wrapper init
2020-08-16 Issue #1: Build switch for raspberry pi target
    [build_switches.h]
2020-08-16 Issue #1: Build switch name fixed
    [build_switches.h]
2020-08-19 Issue #2: Accel/Gyro/Mag functions callable from C++
    [nxp.py, nxp_interface_api.cpp, nxp_interface_api.h]
2020-08-20 Issue #2: C++ Api to Python NXP module complete
    [main.cpp, nxp.py, nxp_interface_api.cpp]
2020-09-02 Issue #9: Added buildswitch, includes not working right on Desktop yet
    [build_switches.h, main.cpp, nxp_interface_api.h]
2020-09-02 Issue #9: Build passes on Desktop
    [nxp_interface_api.h]
2020-09-07 Issue #9: Added dummy functions for non-sensor targets
    [main.cpp, nxp_interface_api.cpp, nxp_interface_api.h]
2020-09-07 reorganizing into device/demos folders
2020-09-07 Moving device related files into 'device' folder
2020-09-07 Issue #8: Initialized server py script
    [server.py]
2020-09-07 Issue #8: Server can receive data + test client script
    [client.py, server.py]
2020-09-08 Issue #8: Initialized wireless api files
    [build_switches.h, wireless_api.cpp, wireless_api.h]
2020-09-09 Reorganized device files, changed makefile accordingly
2020-09-09 Issue #4: Added a unit test module
    [TEST_nxp_api.cpp, build_switches.h, main.cpp, unit_tests.h]
2020-09-12 Issue #8: Moved PythonAssert function into common python file
    [python_common.cpp, python_common.h]
2020-09-12 Issue #8: Connection to client script is successful
    [TEST_nxp_api.cpp, wireless_api.cpp, wireless_api.h]
2020-09-14 Backup before switching to bluetooth
2020-09-20 Issue #7: Module for interfacing ADC chip on RPi
    [mcp3008_adc.py]
2020-09-20 Removed debugging print statements for RPi nxp module
2020-09-20 Updated build switches for testing on RPi
2020-09-21 Issue #7: Fixed incorrect calling function name for errorPrint
    [mcp3008_adc.py]
2020-09-21 Issue #7: RPi module for selecting mux output
    [cd4051be_mux.py]
2020-09-22 Issue #8: Fixed bool check for SendResponse
    [wireless_api.cpp]
2020-09-22 Issue #7: Added C API for Python Mux module, unit test
    [TEST_mux.cpp, build_switches.h, cd4051be_mux.py, main.cpp, mux.cpp, nxp_interface_api.cpp, unit_tests.h]
2020-09-23 Issue #7: Added C interface to Python ADC module
    [TEST_adc.cpp, adc.cpp, adc.h, build_switches.h, main.cpp, unit_tests.h]
2020-09-23 Issue #7: Updated mux macro name
    [mux.cpp]
2020-09-25 Issue #7: Reading ADC channels through C++
    [adc.cpp, mcp3008_adc.py]
2020-09-25 Issue #7: Fixed possible memory leak
    [mux.cpp]
2020-09-25 Issue #8: Fixed possible memory leak
    [nxp_interface_api.cpp]
2020-09-25 Fixed possible memory leak
    [python_common.cpp]
2020-09-27 Issue #7: All 10 potentiometers can be accessed
    [TEST_flex_sensors_api.cpp, adc.h, build_switches.h, flex_sensors_api.cpp, flex_sensors_api.h, main.cpp, unit_tests.h]
2020-09-27 Issue #7: Function descriptions for flex sensor api
    [flex_sensors_api.cpp]
2020-10-01 Issue #8: Python uart module for RPi
    [uart.py]
2020-10-03 Issue #8: Started C++ uart module
    [build_switches.h, uart.py]
2020-10-05 Issue #8: Fixed bug in client/server Py scripts, added 'quit'
    [client.py, server.py]
2020-10-18 Fix build switches for adc/mux
    [adc.h]
2020-10-27 Backing up client before switching to c2000
2020-10-27 Issue #13: Program runs on C2000
    [TEST_adc.cpp, TEST_flex_sensors_api.cpp, TEST_mux.cpp, TEST_nxp_api.cpp, adc_wrapper.cpp, build_switches.h, flex_sensors_api.cpp, flex_sensors_api.h]
2020-10-31 #17: RPi prototype v1 pinout table
    [PinoutTable_v1.0.0__RPi_3bp__Breadboard_v1.0.0.xlsx]
2020-10-31 #17: Corrected power switch pin
    [PinoutTable_v1.0.0__RPi_3bp__Breadboard_v1.0.0.xlsx]
2020-10-31 Added prototype v1 to readme
2020-11-01 #15: Documented mux select pinout for c2000
    [PinoutTable_v2.0.0__C2000__Breadboard_v1.0.0.xlsx]
2020-11-01 #18: Error directive when multiple hw targets are active
    [build_switches.h]
2020-11-05 #14: init c2000 implementation of adc
2020-11-08 #14: ADC A working
2020-11-08 #14: ADC B set up for PIP capture
2020-11-08 #14: Documented ADC pinout for C2000
    [PinoutTable_v2.0.0__C2000__Breadboard_v1.0.0.xlsx]
2020-11-08 #14: ADC c2000 unit test moved into unit tests folder
2020-11-16 #21: Initialized uart modules for c2000
2020-11-16 Patched compile error for adc unit test
    [unit_tests.h]
2021-01-24 #27: Initial timeline
    [Gantt Chart.xlsx]
2021-01-29 #27: Added speaker HW and amplifiers to gantt chart
    [Gantt Chart.xlsx]
2021-02-07 #41: spice schematic for CCCV circuit
2021-02-11 #41: Fixed dropping charge current during CC phase
2021-03-01 #34: Init drivers for 64x48 LCD
2021-03-01 #34: Included build switches in setup HW
2021-03-02 #34: Arduino interfaces ported to MSP432
2021-03-02 #34: SPI / GPIO working (LCD output is garbage)
2021-03-08 Backing up documentation for viewing on laptop
    [Gantt Chart.xlsx, PinoutTable_v2.0.0__C2000__Breadboard_v1.0.0.xlsx]
2021-03-08 #34: Added SPI rx interrupt vector
2021-03-08 #36: Fixed mux select encoding
    [mux_if.cpp, mux_if.h]
2021-03-08 #36: Removed p5.5 hardcoding from Adc init function
2021-03-08 Basic R/W to HC-05 with UART
2021-03-09 #39: Imported mpu6500 drivers + fixed library compile issues
2021-03-09 Moved Python/C source code into prototype folder
2021-03-09 Moved Python/C header files into prototype folder
2021-03-11 #45: Added function to enable external HW power
2021-03-12 #37: Added bluetooth EN pin mappings to systemIO struct
2021-03-22 #47: Initialized I2c drivers for MPU6500 - hanging on NACK
2021-03-22 #46: Moved global const outside of SPI namespace
2021-03-23 47: Test for SPI interface with MPU6500
2021-03-23 #47: Added compile switches to MPU6500 WHO_AM_I tests
2021-03-24 #35: Fixed issue with interrupt trigger
    [TEST_hc05DeviceName.cpp, uart_if.cpp]
2021-03-25 Moved unit test + main program prototypes into entry_points.h
2021-03-26 #35: Adding reads for current HC-05 configs before writing new configs
2021-03-26 #35: Support for checking HC-05 STATE pin
2021-03-26 #46: LCD HW checkout with arduino
2021-03-26 #47: I2c scanner
2021-03-27 #47: MPU**** arduino test program
2021-03-27 #47: Removing I2C test in main
2021-03-27 #47: Moved MPU6500 SPI test into a separate file
2021-03-28 #47: MPU6050 WHO_AM_I read i2c w/ extra byte
2021-03-28 #47: I2C read / write work
2021-03-28 #47: Fixed function name for MPU6050 i2c WHO_AM_I test
    [TEST_mpu6050WhoAmII2c.cpp, main.cpp, unit_tests.h]
2021-03-28 #47: Backup MPU6050 lib changes before switching libs
2021-03-28 #47: Switching to simpler library
2021-03-28 Revert "#47: Switching to simpler library"
    This reverts commit a124f16900da01e9fb1e9a8fcd3c464f12d5deae.
    [main.cpp]
2021-03-28 #47: Reading pitch, yaw, roll values from DMP
2021-03-28 #46: Added LCD demo build switch
2021-03-29 #47: Fixed clock polarity
    [main.cpp, spi_if.cpp, target_hw_common.cpp]
2021-03-29 Added unit test for delay functions, fixed delay timings
    [TEST_timerDelay.cpp, build_switches.h, main.cpp, spi_if.cpp, target_hw_common.cpp, target_hw_common.h, unit_tests.h]
2021-03-29 #46: Fixed drawString column offset
    [lcd_graphics.cpp, main.cpp]
2021-03-29 #47: Reading raw accel/gyro sensor data
2021-03-29 #47: Moved mpu6050 raw sensor reading unit test into separate file
2021-03-29 #57: Fixed includes for entry_level.h
    [TEST_lcdGraphics.cpp, TEST_lcdProductDemo.cpp, TEST_mpu6050RawSensorData.cpp, TEST_mpu6050WhoAmII2c.cpp, TEST_mpu6500WhoAmISpi.cpp, TEST_timerDelay.cpp]
2021-04-01 #48: Porting to 16MHz - hc05 uart passes
2021-04-01 #48: Porting to 16Mhz - i2c source clock set during runtime
2021-04-01 #48: Porting to 16MHz - SPI clock source set during runtime
2021-04-02 #52: Flex sensor API for MSP432
    [adc_if.cpp, adc_if.h, build_switches.h, flex_sensors_api.cpp, flex_sensors_api.h]
2021-04-03 #53: Reading flex sensor data for all fingers + updating LCD
    [adc_if.cpp, flex_sensors_api.cpp, handTrackingGlove.cpp, mux_if.cpp, mux_if.h, target_hw_common.cpp, target_hw_common.h]
2021-04-03 #53: Shortened flex sensor reading delays after removing LPF circuit
    [flex_sensors_api.cpp]
2021-04-03 #53: Moved flex sensor updates into separate function
    [handTrackingGlove.cpp]
2021-04-03 #54: Added non-blocking read to slave device
2021-04-03 #54: Fixed syntax error in hc05.c
    [hc05.c]
2021-04-04 #54: Disabled build switch for hc05 RW unit test
2021-04-04 #54: Disabled LCD send function to bypass I2C hang issue
2021-04-04 Configured external power switch GPIO
2021-04-04 Modified hc05 configuration script to work with new Uart parameters
2021-04-05 #54: HC-05 configuration script passing consistently, increased power on/off delays to 1s
2021-04-05 #54: Fixed uart clock mismatch with old driverlib version
    [hc05.h]
2021-04-05 #54: DSP side reads flex sensor data from MSP432
    [hc05.c, hc05.h, main.c]
2021-04-05 #54: Glove side sends flex sensor data and receives ACK
    [build_switches.h, handTrackingGlove.cpp]
2021-04-05 #54: Flex sensor 0 controls LPF bin - underflows to 510
    [main.c]
2021-04-05 #54: Non-blocking uart read
2021-04-05 #54: Fixed BT synchronization issues on DSP side
    [main.c]
2021-04-05 #54: Adjusted flex sensor min/max to match actual output
    [main.c]
2021-04-06 #47: Added check in case i2c write receives a NACK
2021-04-06 #47: Adding in raw sensor reading code to main program
2021-04-06 #47: I2c write returns false after receiving a NACK
2021-04-06 #64: Reading raw sensor values on Arduino
2021-04-06 #64: Plotting raw sensor data with serial plotter
2021-04-07 #68: Arduino Pitch and Roll demo
2021-04-07 #68: Sensor fusion library imported
2021-04-07 #47: I2C is not hanging with uP2 drivers
2021-04-07 #47: Added delay after i2c inits
2021-04-07 #47: Configuring power-on register
2021-04-07 #47: Fixing function input buffer point
    [i2c_if.cpp, i2c_if.h]
2021-04-07 #47: Script to determine average gyro error
    [TEST_mpu6050GyroError.cpp, build_switches.h, entry_points.h, handTrackingGlove.cpp, main.cpp, target_hw_common.cpp]
2021-04-07 #47: Subtracted gyro error from readings
    [build_switches.h, mpu6050_api.cpp, mpu6050_api.h]
2021-04-07 #64: Implemented millis and tested Pitch/Roll angles
2021-04-07 #64: Moved Pitch/Roll LCD update into update function
2021-04-08 #65: Added pitch and roll to data packet + updated glove side'
2021-04-08 #51: Initialized SOC unit test, current multi-channel ADC code
2021-04-08 #51: Fixed multi-channel ADC conversion
    [TEST_stateOfCharge.cpp, adc_if.cpp]
2021-04-09 #54: Typecasting pitch/roll to shorts before transfer - glove side
    [data_packet_protocol.h, handTrackingGlove.cpp]
2021-04-09 #54: Receiving pitch and roll works on C2000 side
2021-04-09 #54: Removed pitch/roll lcd update and 'continue' before audio processing
2021-04-09 #54: Pitch and roll mapped to LPF and Pitch effects
2021-04-09 Added Bluetooth 'searching for device' animation
2021-04-09 #54: Fixed spacing issue with output gain printout
    [main.c]
2021-04-11 #54: Printing out flex sensors 1-2 on glove LCD
    [handTrackingGlove.cpp]
2021-04-12 #54: Modified flex sensor readings for dsp side
    [main.c]
2021-04-12 #54: Modified flex sensors api for adafruit sensors
    [flex_sensors_api.cpp]
2021-04-12 Fixed issue with volume not changing
    [main.c]
2021-04-13 #51: uC enters LPM while waiting for ADC channels
2021-04-14 #51: Capturing initial ocv adc reading
2021-04-14 Fixed timer32 and systick lockup issue
    [target_hw_common.cpp]
2021-04-14 Added extra line on LCD for flex sensor 0 data
    [handTrackingGlove.cpp]
2021-04-14 #54: Fixed battery charge offset in linear function
    [state_of_charge_api.cpp]
2021-04-16 Tuning flex sensors + fixed FX toggle
    [main.c]
2021-04-16 Tuned flex sensor 0's lowest ADC reading
    [flex_sensors_api.cpp]
2021-04-17 Fixed running SOC calculation
    [state_of_charge_api.cpp]
